RollMan/woofer_amp/conception.pdf

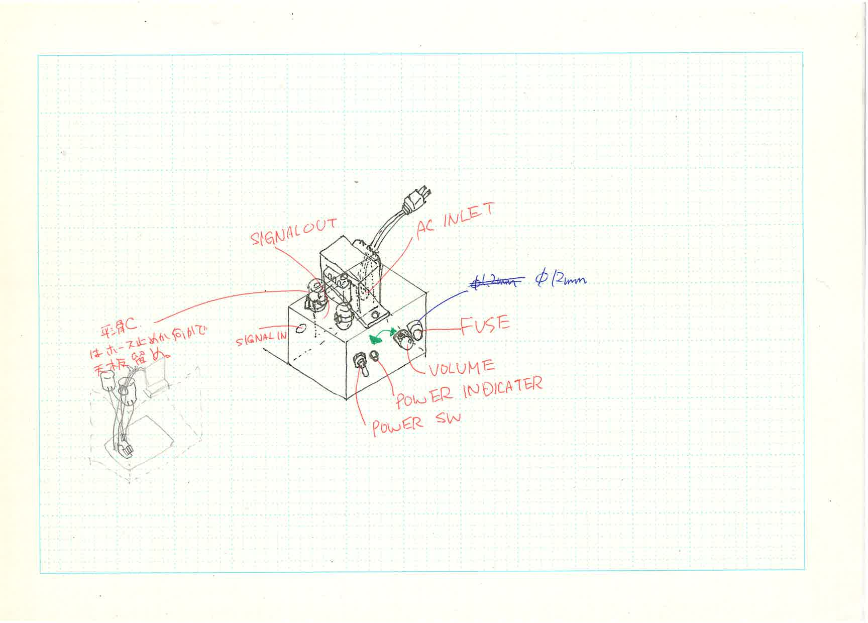
[picture p1: page 1]
