RollMan/woofer_amp/box.dxf

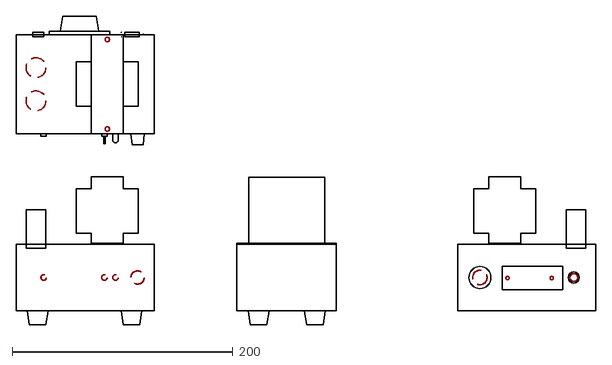
[picture p2: CAD file, 2023-01-21]
box.dxf
525.0 x 279.8
