RollMan/woofer_amp/subwoofer_mix_poweramp.asc

C1: cap; 2.2µ
R1: res; 50k
R2: res; 50k
R3: res; 22k
R4: res; 1k
R5: res; 1k
U1: NJM4580
U2: NJM4580
V1: voltage; SINE(0 10 80); AC 1
V2: voltage; SINE(0 9 1k)
V3: voltage; 16
V4: voltage; 16
Named nets: Vcc, Vee, 0, addout, intout
.tran 20m
.ic V(addout) = 0V
.ic V(intout) = 0V
;.ac oct 100 1 20k
