RollMan/woofer_amp/ltspice/woofer_amp - コピー.asc

C1: cap; 0.047µ
C2: cap; 47µ
C3: cap; 47µ
C4: cap; 1000µ
D1: diode
D2: diode
D3: diode
D4: diode
Q1: npn
Q2: pnp
R1: res; 50k
R2: res; 1k
R3: res; 1k
R4: res; 1k
R5: res; 1k
R6: res; 1
R7: res; 1
R8: res; 3
R9: res; 1k
R10: res; 1k
U1: NJM4580
U2: NJM4580
V1: voltage; 10
V2: voltage; SINE(0.3 0.01 50); AC 0.3
V3: voltage; SINE(0.3 0.01 50); AC 0.3
V4: voltage; 10
V5: voltage; 2
V6: voltage; 2
Named nets: 0, former, VCC, VEE, v1, v2, load, later
.ac oct 10 0.1 20k
.step param C list 4.7u 10u 47u 100u
