RollMan/woofer_amp/ltspice/woofer_amp.asc

C1: cap; 0.047µ
C3: cap; 1000µ
C4: cap; 0.069µ
D1: diode
D2: diode
Q1: npn
Q2: pnp
R1: res; 33k
R2: res; 1k
R3: res; 1k
R4: res; 1k
R5: res; 1k
R6: res; 1
R7: res; 1
R8: res; 3
R9: res; 22k
R10: res; 1k
R11: res; {R}
R12: res; {R2}
U1: NJM4580
U2: NJM4580
V1: voltage; 10
V2: voltage; SINE(0 0.01 50); AC 0.3
V3: voltage; SINE(0 0.01 50); AC 0.3
V4: voltage; 10
Named nets: 0, former, VCC, VEE, v1, v2, load, later
.ac oct 10 1 20k
.step oct param R 0.1 10000 2
.param R2=10000.01-R
