RollMan/woofer_amp/ltspice/woofer_amp_coupling_capacitor.asc

C1: cap; 0.32µ
D1: diode
D2: diode
Q1: npn
Q2: pnp
R1: res; 10k
R2: res; 1k
R3: res; 1k
R4: res; {R}
R5: res; {R}
R6: res; 1
R7: res; 1
R8: res; 3
U1: NJM4580
V1: voltage; 10
V2: voltage; SINE(0 0.3 50); AC 0.3
V3: voltage; SINE(0 1 50); AC 0.3
V4: voltage; 10
Named nets: 0, pre, VCC, VEE, v1, v2, load
.tran 0.1
.step param R list 100 500 1000
