RollMan/woofer_amp/kicad/woofer_amp.kicad_pcb

## KiCad design kicad/woofer_amp.kicad_pcb (2023-01-21)

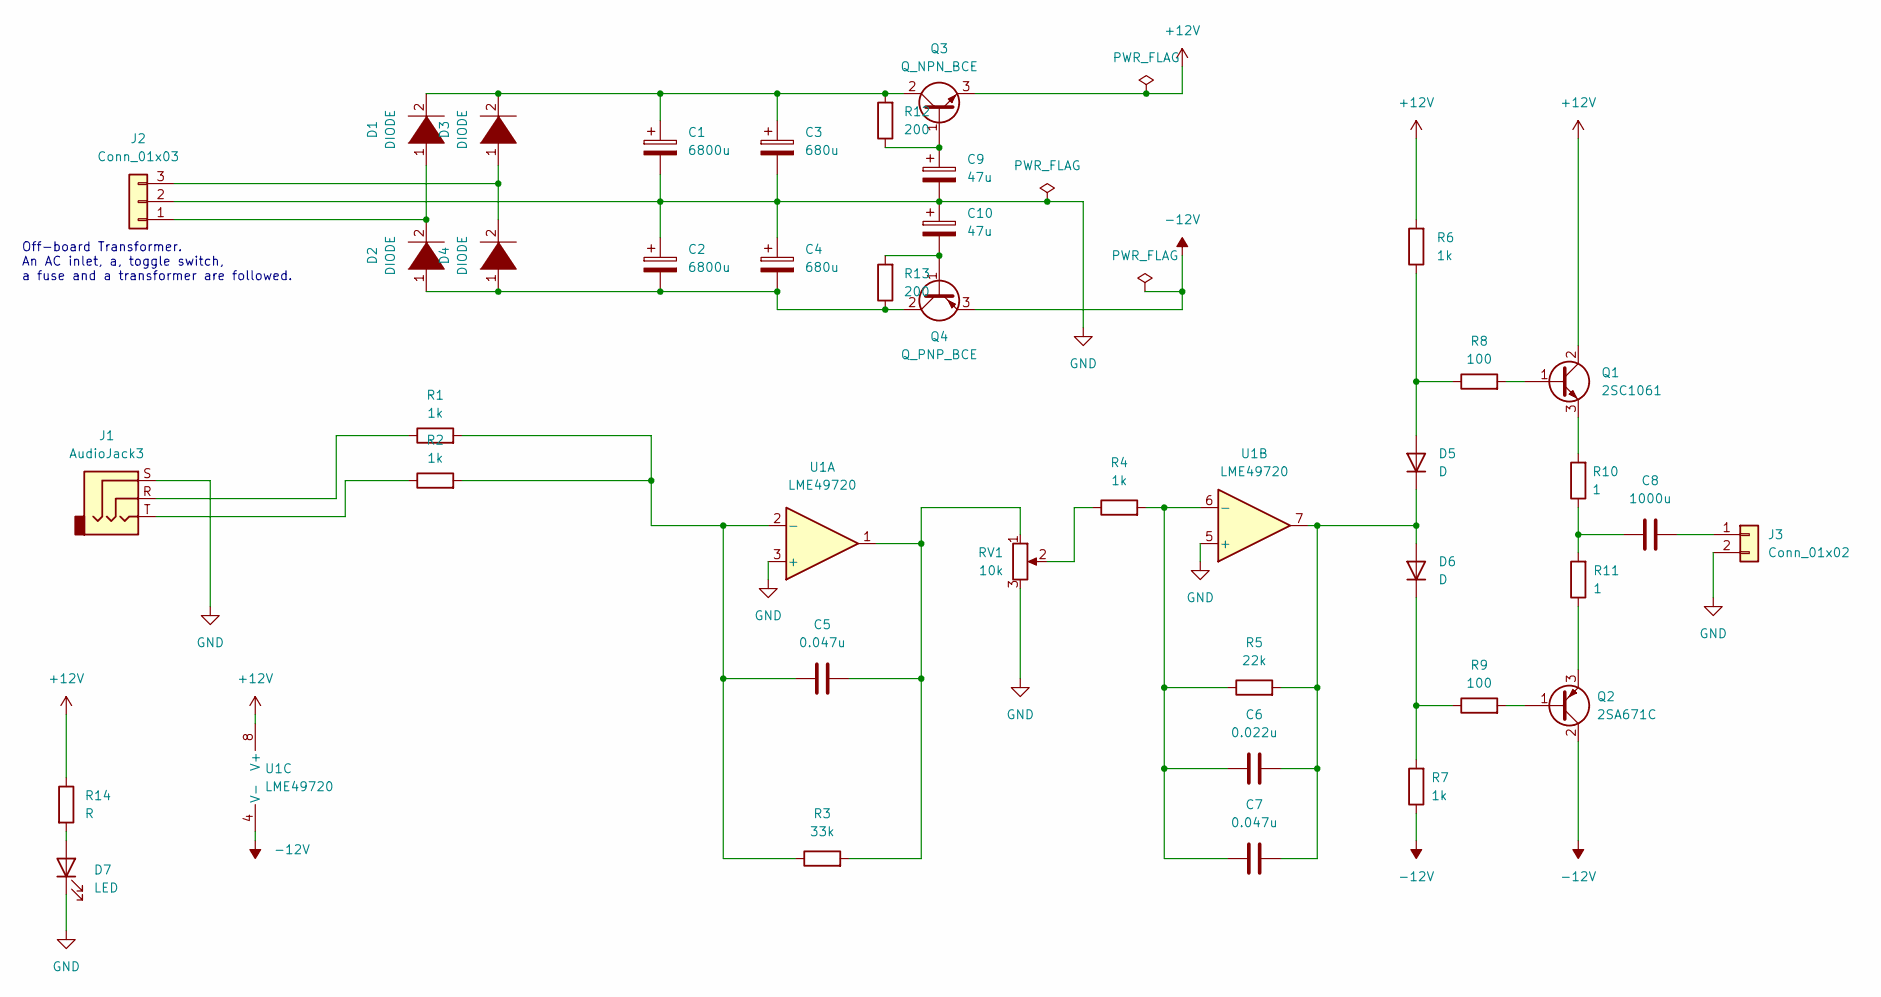
[picture p3: schematic woofer_amp.kicad_sch, Amplifier for SWA-V50]

Parts:
C1, C2: 6800u; PinHeader_1x02_P2.54mm_Vertical
C3, C4: 680u; CP_Radial_D8.0mm_P3.80mm
C5, C7: 0.047u; C_Disc_D7.0mm_W2.5mm_P5.00mm
C6: 0.022u; C_Disc_D5.0mm_W2.5mm_P5.00mm
C8: 1000u; C_Radial_D16.0mm_H25.0mm_P7.50mm
C9, C10: 47u; CP_Radial_D8.0mm_P3.80mm
D1, D2, D3, D4: DIODE; D_A-405_P10.16mm_Horizontal
D5, D6: D; D_A-405_P10.16mm_Horizontal
D7: LED; PinHeader_1x02_P2.54mm_Vertical
J1: AudioJack3; PinHeader_1x03_P2.54mm_Vertical
J2: Conn_01x03; PinHeader_1x03_P2.54mm_Vertical
J3: Conn_01x02; PinHeader_1x02_P2.54mm_Vertical
Q1: 2SC1061; TO-220-3_Vertical
Q2: 2SA671C; TO-220-3_Vertical
Q3: Q_NPN_BCE; TO-220-3_Vertical
Q4: Q_PNP_BCE; TO-220-3_Vertical
R1, R2, R4, R6, R7: 1k; R_Axial_DIN0207_L6.3mm_D2.5mm_P10.16mm_Horizontal
R3: 33k; R_Axial_DIN0207_L6.3mm_D2.5mm_P10.16mm_Horizontal
R5: 22k; R_Axial_DIN0207_L6.3mm_D2.5mm_P10.16mm_Horizontal
R8, R9: 100; R_Axial_DIN0207_L6.3mm_D2.5mm_P10.16mm_Horizontal
R10, R11: 1; R_Axial_DIN0207_L6.3mm_D2.5mm_P10.16mm_Horizontal
R12, R13: 200; R_Axial_DIN0207_L6.3mm_D2.5mm_P10.16mm_Horizontal
R14: R; R_Axial_DIN0207_L6.3mm_D2.5mm_P10.16mm_Horizontal
RV1: 10k; PinHeader_1x03_P2.54mm_Vertical
U1: LME49720; DIP-8_W7.62mm

Connections:
+12V: Q1.2 (C), Q3.3 (E), R6.2, R14.1, U1.8 (V+)
-12V: Q2.2 (C), Q4.3 (E), R7.1, U1.4 (V-)
GND: C1.2, C2.1, C3.2, C4.1, C9.2, C10.1, D7.1 (K), J1.S, J2.2, J3.2, RV1.3, U1.3 (+), U1.5 (+)
unnamed: C1.1, C3.1, D1.2 (A), D3.2 (A), Q3.2 (C), R12.2
unnamed: C2.2, C4.2, D2.1 (K), D4.1 (K), Q4.2 (C), R13.1
unnamed: C5.1, R1.2, R2.2, R3.1, U1.2 (-)
unnamed: C5.2, R3.2, RV1.1, U1.1
unnamed: C6.1, C7.1, R4.2, R5.1, U1.6 (-)
unnamed: C6.2, C7.2, D5.1 (K), D6.2 (A), R5.2, U1.7
unnamed: C8.1, R10.1, R11.2
unnamed: C8.2, J3.1
unnamed: C9.1, Q3.1 (B), R12.1
unnamed: C10.2, Q4.1 (B), R13.2
unnamed: D1.1 (K), D2.2 (A), J2.1
unnamed: D3.1 (K), D4.2 (A), J2.3
unnamed: D5.2 (A), R6.1, R8.1
unnamed: D6.1 (K), R7.2, R9.1
unnamed: D7.2 (A), R14.2
unnamed: J1.R, R1.1
unnamed: J1.T, R2.1
unnamed: Q1.1 (B), R8.2
unnamed: Q1.3 (E), R10.2
unnamed: Q2.1 (B), R9.2
unnamed: Q2.3 (E), R11.1
unnamed: R4.1, RV1.2

Notes on the sheet:
Off-board Transformer. An AC inlet, a, toggle switch, a fuse and a transformer are followed.

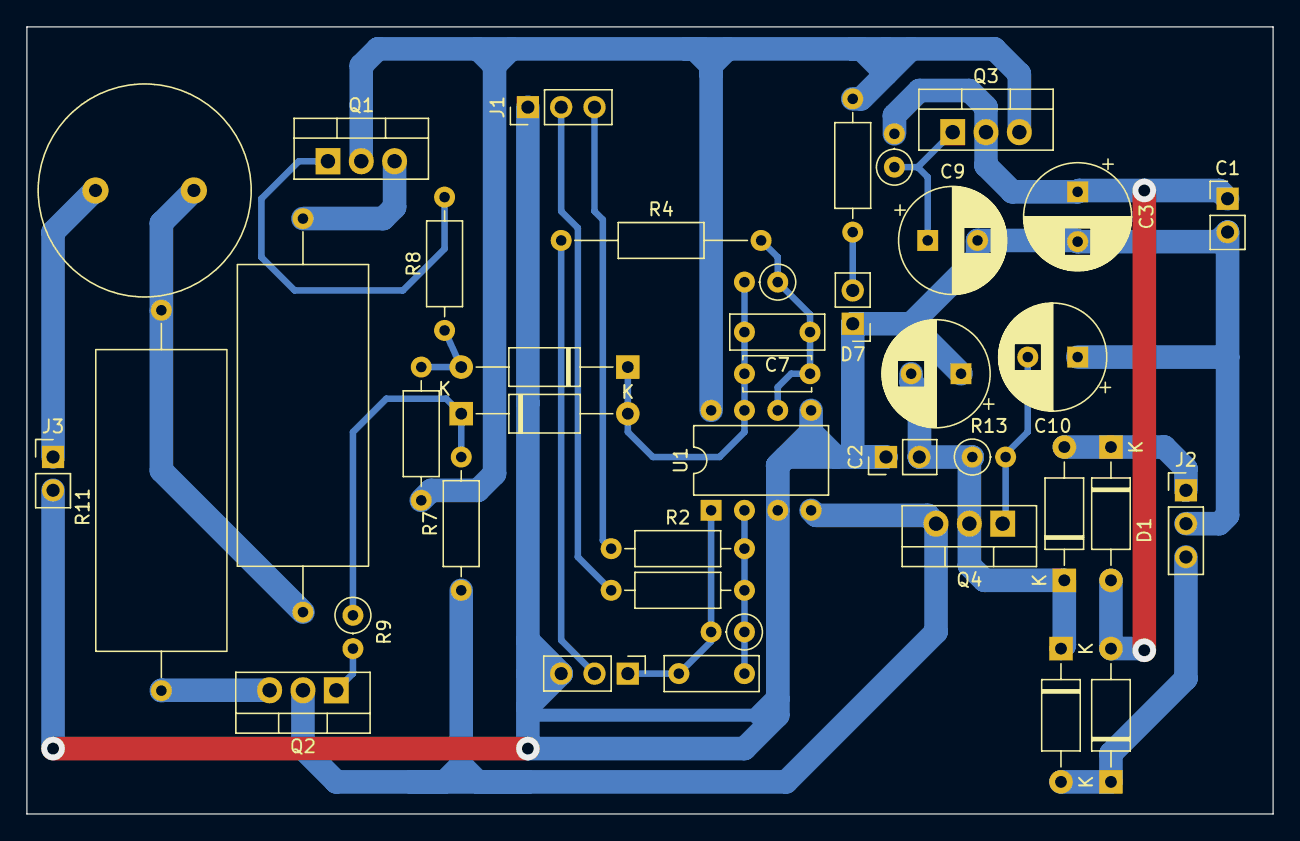
[picture p4: board woofer_amp.kicad_pcb from above]

Board: 2 copper layers, 95.0 x 60.0 mm, 40 parts (0 on the bottom side), 25 nets.
